mnruecke/WOTAN/UI_WOTAN/wotan_scripts_6ch/run_sequence_6channel.py

# -*- coding: utf-8 -*-
"""
%  ========================================
 % 
 % This code is supplementary material for the IWMPI 2018, Hamburg, Germany 
 %
 % Martin.Rueckert@physik.uni-wuerzburg.de
 %
 % Copyright (C) 2017 University of Wuerzburg, Experimental Physics 5, Biophysics
 % https://www.physik.uni-wuerzburg.de/ep5/magnetic-particle-imaging/
 %
 % WOTAN is free software: you can redistribute it and/or modify
 % it under the terms of the GNU General Public License version 3 as
 % published by the Free Software Foundation.
 %
 % WOTAN is distributed in the hope that it will be useful,
 % but WITHOUT ANY WARRANTY; without even the implied warranty of
 % MERCHANTABILITY or FITNESS FOR A PARTICULAR PURPOSE.  See the
 % GNU General Public License for more details.
 %
 % You should have received a copy of the GNU General Public License
 % along with WOTAN.  If not, see <http://www.gnu.org/licenses/>.
 % ========================================
% Description: 
%
% control script for interacting with the WOTAN-PSoC firmware.
%
% Connect with CY8CKIT-059-kit via USB-to-UART in the WOTAN-Firmware.
% Running 'uart_control_python.py' starts the measurement, reads the
% resulting data stream and saves data as ascii-table. 
%
% Default measurement with WOTAN: 
%   - duration: 15 ms with 2 MS/s at 12 bit resolution -> 60 KB uint16 data
%     (limited because of 64 KB SRAM on PSoC 5LP)
%   - transfer to PC takes approx. 5 sec at baudrate = 115200
%   - the USBFS-component on PSoC 5LP allows 12.5 Mbps (i.e. 100x faster)
%
%
%
%  This script needs the 'pyserial' package:
%    https://pythonhosted.org/pyserial/index.html
%    ( download zip-file and install e.g. with "pip install pyserial")  
%
%   in addition, numpy and  matplotlib are required for visualization
%   (often included in scientific python environments like 'anaconda',
%   'spyder' etc.
%
% ========================================
"""




""" --- Required parameters ---- """ 
serialPort = '\\\\.\\COM4' 

# B) baudrate
baudrate = 1382400#921600


receiver_channel = b'7'  # b'7' = "Sig_In", b'1'...b'6' = aux_in_1...aux_in_6

""" ----------------------------- """




import serial
import time
import struct
import os
import os.path

import numpy as np
import matplotlib.pyplot as plt



""" main settings """
# serial port
time_out       = 10
nameDataFiles  = 'mpi_data' 
save_data      = 0

# sequence details
bytesPerSample = 2
timePerSample  = 0.0005 # sample time in ms
sequDuration   = 15 # sequence duration in ms
numOfSamples   = int(sequDuration/timePerSample)
bufInputSize   = numOfSamples * bytesPerSample
adcVoltPerBit    = 4.80 / 4096 # scaling factor for ADC data: PSoC-VDD/ADC-res

# list of commands defined in WOTAN
p_run_sequ  = b'r' # starts the sequence
p_get_data  = b'o' # request binary ADC data of last measurement
p_trig_dir  = b'x' # setting the trigger to output (x: trig out, y: trig in)
p_dac_range = b'h' # setting DAC output voltage range: 'l' for 0...1V ([l]ow; 'h' for 0...4V ([h]igh)

""" END - main settings """



""" start measurement on PSoC and get data """
try: # open and interact with serial port 
    ser = serial.Serial( serialPort, baudrate, timeout=time_out)
    # run MPI sequence on psoc
    
    ser.write( receiver_channel )
    time.sleep(0.001)
    ser.write( p_trig_dir )
    time.sleep(0.001)
    ser.write( p_dac_range )
    time.sleep(0.001)
    
    ser.write( p_run_sequ )
    time.sleep(0.030)
    ser.flushInput()
    time.sleep(0.001)
    ser.write( p_get_data )
    time.sleep(0.001)
    
    # get data as byte stream 
    adc_data_bin = ser.read(bufInputSize)
    # transform byte stream into int16 array
    adc_data_int16 = struct.unpack('>'+'H'*int(len(adc_data_bin)/bytesPerSample),adc_data_bin)
    
finally: # close serial port
    ser.close()
    
    print(len(adc_data_int16))


if len(adc_data_bin) == numOfSamples*bytesPerSample: # check if run was successful
    #  data correction routines:
    # find and correct scaling difference between ADC 1 (even samples)
    # and ADC 2 (odd samples)
    # (this method fails if signal has steps or goes into saturation!)

    adc1 = adc_data_int16[0::2]
    adc2 = adc_data_int16[1::2]
  
#    adc=[];
#    for i in adc_data_int16:
#        adc.append(adc_data_int16[i]+1)
#    adc1 = adc[0::2]
#    adc2 = adc[1::2]
    
    adc1DIVadc2 = 0;
    for sp in range(len(adc1)):
        adc1DIVadc2 += (adc1[sp]-adc2[sp])/(adc1[sp]+adc2[sp])*2/len(adc1)
    
    adc_data_corr = np.zeros(len(adc_data_int16))
    adc_data_corr[0::2] = adc1
    adc_data_corr[0::2] = adc_data_corr[0::2] *(1-adc1DIVadc2)
    adc_data_corr[1::2] = adc2
        
    # visualize data
    dat_time = np.arange(0,sequDuration,timePerSample)
    dat_sig  = adc_data_corr * adcVoltPerBit
    plt.plot( dat_time, dat_sig, dat_time, dat_sig,'+')
    plt.xlabel('time [ms]')
    plt.ylabel('signal [V]')
    plt.show()  
    
           
            
    
    
    """ Write data to disk """
    if( save_data ):
        #  save data as ascii table
        # write data in file with continuous numbering
        cnt = 0
        data_file_name = nameDataFiles + '_' + str(cnt) + '.txt'
        while os.path.isfile( data_file_name ): #prevents overriding files
            cnt += 1
            data_file_name = nameDataFiles + '_' + str(cnt) + '.txt'
        with open( data_file_name , 'w') as f:
            for dat in adc_data_corr:
                f.write("%s\n" % int(dat))
            print( 'Data written to: ' + data_file_name +
                  '  (' + str(len(adc_data_int16)) + ' samples)')
        
else:
    print("\n\n\nPSoC doesn't seem ready. Please try again. " +\
          "(WOTAN firmware requires approx. 5 sec. after " +\
          "programming for sequence calculation.)\n\n\n")
        
            
