mnruecke/WOTAN/(commit log)

2017-11-26 add complete PSoC firmware to repo
    [WOTAN.sdf]
2018-01-06 fixing bug in USBFS control sequence
    [main.c]
2018-01-18 fixing bluetooth code extension
    [main.c]
2018-03-06 cleaning repo
    [WOTAN.sdf]
2018-03-09 remove amplifier from receive chain
2018-05-04 fix time scale in generate_sequence.py
    [generate_sequence.py]
2018-05-06 fix scaling and sequence jumps in generate_sequence.py
    [generate_sequence.py]
2018-05-07 Allow trigger pin P3.0 to be used as either trigger-input or trigger-output
2018-05-09 rename current version from WOTAN_Simplified to WOTAN
2018-05-09 finish renaming current project into WOTAN
2018-05-14 Add USBUART driver file for Windows 7 to root directory
2018-05-16 Change usbfs_interface for sending adc1 and adc2 binary data interleaved as the case in uart_interface and ble_uart_interface
2018-06-26 Including two options for allowing changing the DAC range between 0...1V and 0...4V
2018-07-09 fixing external trigger (in, out) and manual trigger
    [main.c]
2018-07-30 workaround for bluetooth: adding time delays in UI_WOTAN scripts and in main()->uart_interface() to avoid buffer overrun
    [generate_sequence.py, main.c, run_sequence.py]
2019-04-11 corrections in Readme.md and the title page in the schematic
2019-04-12 correct comments im main.c
    [main.c]
2019-04-12 schematic: wrong title page
2023-02-05 remove com buffer, add buffer for ch1, ch2 sample hold splitter, move flash memory section for DAC1..4 to 0x2000, 0x2800, 0x3000, 0x3800 (using 0xA000 seems to cause sporadic flash memory errors - bu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
    [main.c]
